RTimothyEdwards/sky130_ef_ip__rdac3v_8bit/(commit log)

2024-03-01 Seeded repository with files from the local version.
    [dac_column.sch, dac_column_dummy.sch, dac_half.sch, dccurrent_vdd.sch, level_shifter.sch, passtrans.sch, sky130_ef_ip__rdac3v_8bit.sch, sky130_ef_ip__rdac3v_8bit_tb.sch]
2024-03-04 Changed the "dut.sym" so that there is only one symbol, which is the one in the xschem/ directory, and that is the one used in the testbenches.
    [dccurrent_vdd.sch, transient_sine.sch, voltage_output.sch]
2024-03-05 Added "collate: iterations" to the INL Monte Carlo simulation as a way to compact results that is more in line with the current CACE syntax. Probably this should be made a default method of handling 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
2024-03-08 Corrected the name of the layout (prior to fixing issues with CACE related to finding and running extraction on the layout). Changed the paths used for the schematics so that they are relative to the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
    [dccurrent_vdd.sch, transient_sine.sch, voltage_output.sch]
2024-03-10 Modified the transient simulation, which was unrealistically sending data at 1GHz; plus the rise and fall times of the digital bits were set lower than the rate of presentation of the bits, causing t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
    [transient_sine.sch]
2024-04-15 Updated the top-level layout so that the follower amplifier points to the updated name of the dependent repository for the sample and hold circuit (sky130_ef_ip__samplehold, not sample_and_hold).
2024-06-07 Modified the DAC layout to accommodate changes made to the dependency on "follower_amp" from sky130_ef_ip__samplehold. This change improves the DAC's performance to be linear within 1 lsb up to very 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
    [sky130_ef_ip__rdac3v_8bit.sch]
2024-06-09 Adding all mods for fixing verification issues in sche and suymbol as well as phys verification for layout.
    [dac_column.sch, dac_half.sch, passtrans.sch, sky130_ef_ip__rdac3v_8bit.sch]
2024-06-11 Adding all of the edits to get schematic extraction and symbol extraciton clean
    [dac_column.sch, dac_column_dummy.sch, dac_half.sch, passtrans.sch, sky130_ef_ip__rdac3v_8bit.sch]
2024-06-13 Modified the schematic to correct LVS property errors. One error was that the diodes did not have the correct area entered in the schematic. The other was that the resistor subcell was created prior 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
    [dac_column.sch, dac_column_dummy.sch, level_shifter.sch]
2024-06-14 Add CI and convert datasheet to YAML
    [dccurrent_vdd.sch, transient_sine.sch, voltage_output.sch]
2024-06-14 Revised the repository to make use of a Makefile and a make target "get_ip_blocks" to clone the dependency of the follower amplifier from the "samplehold" repository. Adjusted paths in the schematic 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
    [sky130_ef_ip__rdac3v_8bit.sch]
2024-06-26 Corrected a hash suffix on a device in the rdac_level_shifter introduced when working in a project calling the RDAC as a dependency (needs to be fixed in magic).
2024-09-12 initial cace support
    [sky130_ef_ip__rdac3v_8bit.sch]
2024-09-18 handling dependencies of the rdac
    [sky130_ef_ip__rdac3v_8bit.sch]
2024-10-01 Update project
    [dccurrent_vdd.sch, transient_sine.sch, voltage_output.sch]
2024-11-11 Re-ran LVS after ensuring that the sample & hold submodule was properly initialized. New LVS results being committed; no actual layout or schematic changes were made.
